Cuna5/CloudFlyIMU/恒温AI_IMU姿态测量系统方案.md

# 基于恒温控制、神经网络零漂预测与自适应 EKF 的智能 IMU 姿态测量系统方案

## 1. 项目名称

**基于恒温控制、神经网络零漂预测与自适应 EKF 的智能 IMU 姿态测量系统**

也可以作为课程设计题目写成：

> **基于多传感器融合与温漂补偿的高稳定 IMU 姿态检测系统**

---

## 2. 项目背景与意义

MEMS IMU 在无人机、机器人、机械臂、室内定位和姿态测量系统中应用广泛。但在实际使用过程中，IMU 会受到温度变化、陀螺仪零漂、磁场干扰等因素影响，导致姿态角估计不稳定，尤其是偏航角 Yaw 容易产生长期漂移。

本设计针对以下问题：

```text
1. 温度变化导致 BMI088 零漂变化；
2. 陀螺仪零漂导致姿态角长期漂移；
3. 磁力计受到干扰时，九轴融合容易把 Yaw 拉偏；
4. 普通六轴/九轴算法无法根据磁场可靠性自适应切换。
```

因此，本系统提出一种结合：

```text
恒温控制
+
神经网络零漂预测
+
磁干扰检测
+
自适应 EKF 姿态融合
```

的智能 IMU 姿态测量方案，以提升复杂环境下姿态估计的稳定性和鲁棒性。

---

## 3. 总体设计目标

本系统的目标不是单纯读取 IMU 数据，而是构建一个具有误差抑制能力的智能姿态测量模块。

### 3.1 核心目标

```text
1. 通过电阻加热和 PID 控制，使 IMU 工作在稳定温度区间；
2. 采集 BMI088 在不同温度下的静止零漂数据；
3. 利用神经网络预测陀螺仪零偏 bgx、bgy、bgz；
4. 利用 EKF 融合陀螺仪、加速度计和磁力计数据；
5. 检测磁干扰，并根据磁场可靠性动态调整磁力计权重；
6. 在磁干扰环境下自动退化为六轴融合，在磁场正常时使用九轴融合；
7. 通过上位机显示温度、零漂、磁场可靠性和姿态角变化。
```

### 3.2 最终实现功能

```text
1. BMI088 六轴数据采集；
2. IST8310 磁力计数据采集；
3. BMP280 温度数据采集；
4. 电阻加热 PID 恒温控制；
5. 陀螺仪零漂数据采集与建模；
6. MLP 神经网络零漂预测；
7. EKF 姿态融合；
8. 磁干扰可靠性判断；
9. 六轴/九轴自适应融合；
10. 姿态角、温度、磁场状态、EKF 模式实时显示。
```

---

## 4. 总体硬件方案

### 4.1 器件选型

| 模块 | 器件 | 作用 |
|---|---|---|
| 主控 | STM32H743IIT6 | 传感器采集、PID 控制、AI 推理、EKF 融合、通信 |
| 六轴 IMU | BMI088 | 三轴加速度、三轴陀螺仪 |
| 磁力计 | IST8310 | 地磁测量、九轴融合、磁干扰检测 |
| 温度/气压 | BMP280 | 第一版用于温度反馈或环境参考 |
| 加热器 | 5V 10Ω 5W 功率电阻 | 给 IMU 模块恒温 |
| 开关器件 | YJL3400A N-MOSFET | PWM 控制加热电阻 |
| 参数存储 | W25Q64 (QSPI, 8 MB) | 持久化存储 PID 参数、EKF 初始值等配置，带 CRC32 校验 |
| 显示模块 | OLED，可选 | 显示温度、姿态、磁场状态和 EKF 模式 |
| 通信接口 | USB CDC / UART | 上传数据到 Python / MATLAB 上位机 |
| 上位机 | Python / MATLAB | 数据记录、模型训练、曲线绘制 |

### 4.2 暂定硬件组合

```text
STM32H743IIT6
+
BMI088
+
IST8310
+
BMP280
+
5V 10Ω 5W 功率电阻
+
YJL3400A MOSFET
+
OLED
+
USB CDC / UART
```

---

## 5. 系统结构设计

### 5.1 系统功能框图

```text
BMI088
  ├── 加速度 ax, ay, az
  └── 角速度 gx, gy, gz

IST8310
  └── 磁场 mx, my, mz

BMP280
  ├── 温度 T
  └── 气压 P，可选

电阻加热 + MOSFET
  └── 恒温控制

STM32H743
  ├── 传感器数据采集
  ├── PID 恒温控制
  ├── AI 零漂预测
  ├── 磁干扰可靠性判断
  ├── 自适应 EKF 姿态融合
  └── 数据显示与上传
```

### 5.2 系统数据流

```text
BMI088 / IST8310 / BMP280 数据采集
        ↓
温度读取与 PID 恒温控制
        ↓
IMU 原始数据预处理
        ↓
神经网络预测陀螺仪零偏
        ↓
陀螺仪数据补偿
        ↓
磁场可靠性判断
        ↓
自适应 EKF 姿态融合
        ↓
输出 Roll / Pitch / Yaw
        ↓
OLED 显示 / 上位机记录
```

---

## 6. 结构与安装方案

### 6.1 恒温 IMU 模块结构

建议制作一个小型恒温仓，将 BMI088、BMP280、均热层和加热电阻集成在一起。

```text
┌────────────────────────────┐
│          保温外壳            │
│                            │
│   IST8310 磁力计             │ ← 尽量远离加热电流线
│                            │
│   BMI088 + BMP280           │ ← 尽量靠近，处于同一热区
│        ↓                   │
│   铜片 / 铝片均热层           │
│        ↓                   │
│   功率电阻加热              │
│                            │
└────────────────────────────┘
```

### 6.2 安装注意事项

```text
1. BMI088 和 BMP280 尽量靠近；
2. 功率电阻不要直接贴 BMI088 芯片；
3. 电阻和 IMU 之间加入铜片或铝片作为均热层；
4. IST8310 尽量远离功率电阻、MOSFET 和加热电源线；
5. 加热线正负线应并排走线，减少磁场环路；
6. MOSFET 建议放在恒温仓外部；
7. 恒温仓可使用泡棉、亚克力或 3D 打印外壳进行保温；
8. 靠近磁力计的位置避免使用铁螺丝，优先使用塑料螺丝、铜螺丝或尼龙柱。
```

---

## 7. 电阻加热与 MOSFET 控制方案

### 7.1 加热器件选择

第一版推荐：

```text
5V 电源
10Ω 5W 功率电阻
最大加热功率约 2.5W
```

计算：

```text
P = V² / R = 5² / 10 = 2.5W
I = V / R = 5 / 10 = 0.5A
```

该功率适合小型 IMU 恒温仓。

### 7.2 MOSFET 选择

使用 **YJL3400A N-MOSFET** 作为低边开关。

### 7.3 接线方式

```text
5V 正极
  ↓
10Ω 加热电阻
  ↓
YJL3400A D 极
YJL3400A S 极
  ↓
GND
```

控制端：

```text
STM32 PWM 引脚 → 100Ω 电阻 → MOSFET G 极
MOSFET G 极 → 10k 下拉电阻 → GND
```

注意：

```text
1. STM32 GND、加热电源 GND 必须共地；
2. MOSFET 要确认 G、D、S 引脚顺序；
3. 加热电流线应远离 IST8310；
4. 加热电源线正负线尽量靠近布线；
5. 软件必须设置过温保护。
```

### 7.4 恒温控制目标

推荐恒温目标：

```text
目标温度：40℃ 或 45℃
允许波动：±0.5℃ 左右
安全断电温度：55℃
```

PWM 频率建议：

```text
1 Hz ~ 10 Hz
```

加热是慢系统，不需要高频 PWM。

---

## 8. 软件总体架构

软件可以分为 6 层：

```text
1. 传感器采集层
   - BMI088
   - IST8310
   - BMP280

2. 恒温控制层
   - PID 控制电阻加热

3. 数据预处理层
   - 单位转换
   - 滤波
   - 归一化
   - 静止检测

4. AI 零漂预测层
   - MLP 预测 bgx、bgy、bgz

5. 自适应 EKF 层
   - 陀螺仪预测
   - 加速度计修正
   - 磁力计修正
   - 磁干扰权重调节

6. 显示与通信层
   - OLED 显示
   - USB CDC / UART 上传
```

### 8.1 主循环流程

```text
1. 读取 BMI088 的 ax、ay、az、gx、gy、gz；
2. 读取 IST8310 的 mx、my、mz；
3. 读取 BMP280 的温度 T；
4. 执行 PID 恒温控制；
5. 对 IMU 数据进行滤波和归一化；
6. 判断当前是否处于静止或低动态状态；
7. AI 模型预测陀螺仪零偏 bgx、bgy、bgz；
8. 对陀螺仪数据进行零偏补偿；
9. EKF 使用陀螺仪进行姿态预测；
10. 加速度计修正 Roll / Pitch；
11. 计算磁场可靠性；
12. 根据磁场可靠性动态调整磁力计观测权重；
13. EKF 输出 Roll / Pitch / Yaw；
14. OLED 显示状态；
15. 上传数据到上位机。
```

---

## 9. EKF 姿态融合设计

### 9.1 状态量设计

推荐 EKF 状态量：

```text
x = [q0, q1, q2, q3, bgx, bgy, bgz]
```

其中：

| 状态量 | 含义 |
|---|---|
| q0, q1, q2, q3 | 姿态四元数 |
| bgx, bgy, bgz | 陀螺仪零偏 |

### 9.2 预测步骤

陀螺仪原始测量值：

```text
ω_raw = [gx, gy, gz]
```

AI 或 EKF 估计的零偏：

```text
b_g = [bgx, bgy, bgz]
```

补偿后的角速度：

```text
ω = ω_raw - b_g
```

利用角速度进行四元数预测：

```text
q_k = q_{k-1} + 1/2 · Ω(ω) · q_{k-1} · dt
```

然后归一化：

```text
q_k = q_k / ||q_k||
```

### 9.3 加速度计更新

加速度计在静止或低动态情况下主要测量重力方向。

理论重力方向：

```text
g_n = [0, 0, 1]
```

根据当前四元数预测机体系下重力方向：

```text
g_b_pred = R(q)^T · g_n
```

实际加速度归一化：

```text
a_meas = [ax, ay, az] / ||a||
```

残差：

```text
r_acc = a_meas - g_b_pred
```

EKF 使用该残差修正 Roll 和 Pitch。

### 9.4 磁力计更新

磁力计用于修正 Yaw。

预测机体系下磁场方向：

```text
m_b_pred = R(q)^T · m_n
```

实际磁力计归一化：

```text
m_meas = [mx, my, mz] / ||m||
```

残差：

```text
r_mag = m_meas - m_b_pred
```

EKF 使用该残差修正偏航角 Yaw。

---

## 10. 磁干扰检测与自适应融合

### 10.1 磁干扰问题

九轴融合依赖磁力计修正 Yaw，但磁力计容易受到以下因素干扰：

```text
1. 磁铁；
2. 电机；
3. 大电流导线；
4. 铁磁材料；
5. 加热电流回路；
6. 电源模块和开关电路。
```

因此系统需要判断磁力计是否可信。

### 10.2 磁场模长计算

```text
B = sqrt(mx² + my² + mz²)
```

### 10.3 磁场可靠性评分

定义磁场可靠性：

```text
S_mag ∈ [0, 1]
```

其中：

```text
S_mag = 1：磁场可靠；
S_mag = 0：严重磁干扰。
```

可靠性判断依据：

```text
1. 磁场模长是否明显偏离正常值；
2. 磁场模长变化率是否过大；
3. 磁场方向是否突变；
4. 磁力计 yaw 与陀螺仪短时预测 yaw 是否冲突；
5. 滑动窗口内 mx、my、mz 或 B 的方差是否过大。
```

### 10.4 自适应 EKF 策略

不建议直接硬切换六轴/九轴，而是动态调整磁力计观测噪声。

```text
磁场可靠：
R_mag 较小
EKF 信任磁力计
系统接近九轴融合

磁场干扰：
R_mag 较大
EKF 降低磁力计权重
系统退化为六轴融合
```

可以设计为：

```text
磁场正常：R_mag = R_mag_base
轻微干扰：R_mag = 10 × R_mag_base
严重干扰：R_mag = 1000 × R_mag_base
```

或者使用连续权重：

```text
R_mag = R_mag_base / (S_mag + 0.01)
```

这样可以实现平滑的六轴/九轴自适应融合。

---

## 11. AI 零漂预测方案

### 11.1 AI 预测目标

第一版只预测陀螺仪零偏：

```text
bgx, bgy, bgz
```

不建议第一版直接预测姿态角误差，因为当前方案暂时不加入角度参考传感器，姿态误差标签不容易获得。

### 11.2 零偏补偿方式

```text
gx_corrected = gx_raw - bgx
gy_corrected = gy_raw - bgy
gz_corrected = gz_raw - bgz
```

补偿后的角速度送入 EKF 进行姿态预测。

---

## 12. AI 训练数据采集方案

### 12.1 数据采集原则

训练 AI 零漂预测模型时，第一版主要采集 **静止温漂数据**。

因为静止状态下理论角速度为：

```text
gx_true = 0
gy_true = 0
gz_true = 0
```

所以实际测得的低频角速度偏移可以近似看作陀螺仪零偏。

### 12.2 数据采集阶段

建议分为以下阶段：

```text
阶段 1：室温静止，关闭加热；
阶段 2：开启加热，从室温升到 40℃ 或 45℃；
阶段 3：恒温保持 10~20 分钟；
阶段 4：关闭加热，自然降温；
阶段 5：重复多次，增加数据多样性。
```

### 12.3 数据记录字段

建议 CSV 格式：

```text
time,T,dT,pwm,ax,ay,az,gx,gy,gz,mx,my,mz
```

字段说明：

| 字段 | 含义 |
|---|---|
| time | 时间戳 |
| T | BMP280 温度 |
| dT | 温度变化率 |
| pwm | 加热 PWM 占空比 |
| ax, ay, az | 加速度计数据 |
| gx, gy, gz | 陀螺仪数据 |
| mx, my, mz | 磁力计数据 |

### 12.4 数据采样频率建议

| 数据 | 建议采样频率 |
|---|---|
| BMI088 加速度/陀螺仪 | 200 Hz 或 500 Hz |
| IST8310 磁力计 | 50 Hz 或 100 Hz |
| BMP280 温度 | 5 Hz 或 10 Hz |
| PID 控制周期 | 1 Hz ~ 10 Hz |
| 上位机记录 | 可统一降采样到 50 Hz 或 100 Hz |

---

## 13. AI 标签生成方案

### 13.1 标签来源

静止状态下：

```text
真实角速度 = 0
```

因此：

```text
陀螺仪低频输出 ≈ 陀螺仪零偏
```

### 13.2 标签生成方式

不要直接用瞬时 gx、gy、gz 作为标签，因为其中包含高频噪声。

建议使用滑动平均或低通滤波：

```text
bgx_label = lowpass(gx)
bgy_label = lowpass(gy)
bgz_label = lowpass(gz)
```

推荐窗口：

```text
2 秒 ~ 5 秒滑动窗口
```

### 13.3 静止数据筛选

为了避免运动数据污染零偏标签，需要进行静止检测。

静止条件可以设置为：

```text
|sqrt(ax² + ay² + az²) - 1g| < threshold_acc
且
|gx|, |gy|, |gz| < threshold_gyro
```

只有满足静止条件的数据才用于训练零漂预测模型。

---

## 14. AI 输入特征设计

推荐第一版输入特征：

```text
T
dT/dt
pwm
ax_mean, ay_mean, az_mean
gx_mean, gy_mean, gz_mean
gx_std, gy_std, gz_std
```

输出：

```text
bgx, bgy, bgz
```

可以写成：

```text
输入：10~12 维特征
输出：3 维陀螺仪零偏
```

### 14.1 特征说明

| 特征 | 作用 |
|---|---|
| T | 表征温度对零偏的影响 |
| dT/dt | 表征升温/降温动态过程 |
| pwm | 表征加热状态 |
| ax_mean, ay_mean, az_mean | 辅助判断姿态和静止状态 |
| gx_mean, gy_mean, gz_mean | 当前窗口陀螺仪均值 |
| gx_std, gy_std, gz_std | 当前窗口陀螺仪噪声水平 |

---

## 15. AI 模型结构

推荐使用小型 MLP。

### 15.1 模型结构

```text
输入层：10~12 维
↓
Dense 32 + ReLU
↓
Dense 32 + ReLU
↓
输出层 3
```

输出：

```text
bgx, bgy, bgz
```

如果希望模型更轻量，可以使用：

```text
Dense 16 + ReLU
↓
Dense 16 + ReLU
↓
Output 3
```

### 15.2 损失函数

使用均方误差：

```text
MSELoss
```

### 15.3 评价指标

```text
1. bgx RMSE
2. bgy RMSE
3. bgz RMSE
4. 补偿前后 gx/gy/gz 均值
5. 补偿前后 gx/gy/gz 标准差
6. 补偿前后静止 Yaw 漂移速度
```

---

## 16. AI 训练流程

### 16.1 训练流程

```text
1. 采集 CSV 数据；
2. Python 读取数据；
3. 对数据进行单位转换和滤波；
4. 进行静止检测；
5. 使用滑动窗口提取特征；
6. 使用低通滤波生成零偏标签；
7. 划分训练集、验证集、测试集；
8. 训练 MLP 模型；
9. 评估模型预测误差；
10. 导出权重；
11. 移植到 STM32。
```

### 16.2 数据集划分

建议不要完全随机打乱每个窗口，而是按实验轮次划分：

```text
第 1~3 次升温/降温数据：训练集；
第 4 次升温/降温数据：验证集；
第 5 次升温/降温数据：测试集。
```

这样更能证明模型具有泛化能力。

---

## 17. AI 模型部署方案

### 17.1 推荐方式：手写 MLP 推理

将训练好的权重导出为 C 数组：

```text
W1, b1
W2, b2
W3, b3
```

在 STM32 中手写：

```text
矩阵乘法
ReLU
输出层计算
```

优点：

```text
1. 模型小，运行快；
2. 不依赖复杂 AI 框架；
3. 便于调试；
4. 适合课程设计。
```

### 17.2 可选方式：TensorFlow Lite Micro

优点是更正规，缺点是移植工作量更大。

第一版建议使用 **手写 MLP 推理**。

---

## 18. AI 与 EKF 的结合方式

### 18.1 第一版推荐方式

先采用简单方式：

```text
BMI088 原始角速度
        ↓
AI 预测 bias
        ↓
角速度补偿
        ↓
EKF 姿态融合
```

公式：

```text
gyro_corrected = gyro_raw - bias_ai
```

### 18.2 后续高级方式

后续可以将 AI 输出的 bias 作为 EKF 的伪观测：

```text
z_bias = bias_ai
```

观测模型：

```text
z_bias = b_g + noise
```

这样 EKF 可以综合自身估计和 AI 预测结果。

---

## 19. 实验验证方案

### 19.1 实验一：恒温控制效果实验

目的：

```text
验证电阻加热和 PID 控制能否将 IMU 附近温度稳定在目标温度。
```

实验步骤：

```text
1. 关闭加热，记录自然温度变化；
2. 开启加热，设定目标温度 40℃ 或 45℃；
3. 记录温度曲线和 PWM 占空比；
4. 观察达到目标温度所需时间；
5. 记录稳定后的温度波动范围。
```

评价指标：

```text
1. 稳定时间；
2. 超调量；
3. 稳态误差；
4. 温度波动范围。
```

目标：

```text
温度稳定在目标温度附近，波动约 ±0.5℃。
```

---

### 19.2 实验二：恒温前后零漂对比

目的：

```text
验证恒温控制是否能减小 BMI088 陀螺仪零漂波动。
```

实验步骤：

```text
1. BMI088 静止放置；
2. 关闭恒温，采集 10~20 分钟；
3. 开启恒温，采集 10~20 分钟；
4. 比较 gx、gy、gz 的均值、标准差和漂移趋势。
```

评价指标：

```text
1. 零偏均值；
2. 零偏标准差；
3. 零偏随温度变化曲线；
4. 静止姿态角漂移速度。
```

目标：

```text
恒温后零偏波动减小。
```

---

### 19.3 实验三：AI 零漂补偿效果

目的：

```text
验证 MLP 模型是否能够预测并补偿陀螺仪零漂。
```

实验步骤：

```text
1. 采集静止温漂数据；
2. 训练 MLP 零漂预测模型；
3. 将模型部署到 STM32 或在上位机离线验证；
4. 比较原始 gyro、恒温 gyro、AI 补偿 gyro。
```

评价指标：

```text
1. 补偿前后 gx/gy/gz 均值；
2. 补偿前后 gx/gy/gz 标准差；
3. 补偿前后静止 Yaw 漂移速度；
4. AI 预测 bias 与标签 bias 的 RMSE。
```

目标：

```text
AI 补偿后静止角速度更接近 0，姿态漂移速度降低。
```

---

### 19.4 实验四：磁干扰自适应 EKF 实验

目的：

```text
验证系统能否在磁干扰下自动降低磁力计权重，避免 Yaw 被错误修正。
```

实验步骤：

```text
1. 正常环境下运行九轴 EKF；
2. 将磁铁、电机或大电流导线靠近 IST8310；
3. 观察磁场模长和磁场可靠性变化；
4. 检查系统是否降低磁力计权重；
5. 移除磁干扰；
6. 观察系统是否恢复九轴融合。
```

显示结果示例：

```text
Mag Reliability: 0.95 → 0.15 → 0.92
EKF Mode: 9-axis → 6-axis → 9-axis
```

目标：

```text
磁干扰时系统不让错误磁力计数据强行修正 Yaw。
```

---

### 19.5 实验五：综合对比实验

比较以下三种方案：

```text
1. 普通六轴姿态解算；
2. 普通九轴姿态解算；
3. 恒温 + AI 零漂预测 + 自适应 EKF。
```

评价指标：

```text
1. 静止漂移量；
2. 磁干扰下 Yaw 跳变量；
3. 温度变化下零偏波动；
4. 姿态角稳定性；
5. 系统模式切换是否平滑。
```

---

## 20. 上位机显示与数据记录

建议上位机使用 Python 或 MATLAB。

### 20.1 需要绘制的曲线

```text
1. 温度 T 曲线；
2. PWM 占空比曲线；
3. gx、gy、gz 原始零偏曲线；
4. AI 预测 bgx、bgy、bgz 曲线；
5. 补偿前后角速度曲线；
6. 磁场模长 B 曲线；
7. 磁场可靠性 S_mag 曲线；
8. Roll / Pitch / Yaw 曲线；
9. EKF 模式变化曲线。
```

### 20.2 OLED 显示内容

可以显示：

```text
Temp: 45.1 C
PWM: 38 %
Mag: Normal / Disturbed
Mode: 9-axis / 6-axis / Adaptive
Bias gx: 0.003 dps
Roll: 1.2 deg
Pitch: -0.5 deg
Yaw: 83.6 deg
```

---

## 21. 开发顺序建议

推荐按以下顺序开发：

```text
第一步：调通 BMI088，输出 ax/ay/az/gx/gy/gz；
第二步：调通 BMP280，读取温度；
第三步：MOSFET 控制电阻加热；
第四步：实现 PID 恒温控制；
第五步：采集无恒温/恒温零漂数据；
第六步：训练 MLP 零漂预测模型；
第七步：STM32 部署 AI 推理；
第八步：调通 IST8310；
第九步：实现六轴 EKF；
第十步：加入磁力计，变成九轴 EKF；
第十一步：加入磁干扰检测和自适应权重；
第十二步：完成实验对比和报告图表。
```

---

## 22. 项目创新点

可以在报告中这样描述：

> 本系统针对 MEMS IMU 在温度变化和磁场干扰环境下姿态测量精度下降的问题，提出一种结合恒温控制、神经网络零漂预测和自适应 EKF 融合的姿态测量方法。系统首先通过功率电阻、MOSFET 和温度传感器构建恒温闭环，使 BMI088 工作在稳定温度区间；随后利用神经网络建立温度、原始惯性数据与陀螺仪零偏之间的非线性映射关系，实现陀螺仪零漂预测与补偿；最后根据磁场模长、方向变化和磁偏航残差构建磁场可靠性指标，动态调整 EKF 中磁力计观测噪声，实现六轴与九轴融合的平滑自适应切换，从而提高姿态测量系统在温漂和磁干扰环境下的稳定性与鲁棒性。

---

## 23. 当前方案优点

```text
1. 传感器课程特色明显：涉及 IMU、磁力计、温度传感器和加热控制；
2. 控制系统完整：包含电阻加热、MOSFET 驱动和 PID 恒温；
3. AI 应用合理：不是为了分类而分类，而是用于零漂预测和误差补偿；
4. 融合算法有深度：加入 EKF 和磁干扰自适应权重；
5. 工程应用明确：可扩展到无人机、机器人、机械臂、室内导航等姿态测量场景；
6. 实验验证可量化：可以通过零偏、温度、Yaw 漂移和磁干扰响应曲线证明效果。
```

---

## 24. 当前方案可能的不足与改进方向

### 24.1 BMP280 温度反馈精度有限

BMP280 的温度读数主要用于气压补偿，第一版可以暂时代替温度反馈，但如果追求更高精度，后续可替换或增加：

```text
TMP117
NTC
PT100 / PT1000
```

### 24.2 暂时没有角度参考

当前方案不加入 AS5600 或转台，因此第一版主要验证：

```text
1. 零偏是否减小；
2. 姿态漂移是否降低；
3. 磁干扰时系统是否能自适应切换。
```

如果后续需要验证绝对角度精度，可以增加：

```text
AS5600 磁编码器
步进电机转台
光电编码器
```

### 24.3 磁力计容易受结构影响

后续需要进行：

```text
硬铁校准
软铁校准
安装位置优化
磁干扰实验
```

### 24.4 AI 模型依赖训练数据质量

训练数据需要覆盖：

```text
升温过程
恒温过程
降温过程
不同环境温度
多次重复实验
```

否则模型泛化能力会较弱。

---

## 25. 最终确定版方案

当前第一版总体方案确定为：

```text
STM32H743IIT6
+
BMI088
+
IST8310
+
BMP280
+
5V 10Ω 5W 电阻加热
+
YJL3400A MOSFET PWM 控制
+
W25Q64 QSPI Flash（参数持久化）
+
PID 恒温
+
MLP 零漂预测
+
自适应 EKF 姿态融合
```

核心技术路线：

```text
恒温控制 → 降低温漂
AI 零漂预测 → 补偿陀螺仪 bias
磁干扰检测 → 判断磁力计可靠性
自适应 EKF → 平滑切换六轴/九轴融合
```

该方案具有较强的课程设计完整性，也具备进一步扩展到无人机、机器人和高稳定姿态测量模块的应用价值。
