Cuna5/CloudFlyIMU/CloudFlyIMU.ioc

Mcu.UserName=STM32H743IITx
PA11.Signal=USB_OTG_FS_DM
PA12.Signal=USB_OTG_FS_DP
PA5.GPIO_Label=BMI_SCK
PA5.Signal=SPI1_SCK
PA6.GPIO_Label=BMI_MISO
PA6.Signal=SPI1_MISO
PA7.GPIO_Label=BMI_MOSI
PA7.Signal=SPI1_MOSI
PA8.Signal=I2C3_SCL
PB10.GPIO_Label=OLED_SCK
PB10.Signal=SPI2_SCK
PB12.GPIO_Label=OLED_RST
PB12.Signal=GPIO_Output
PB14.GPIO_Label=DEBUG_TX
PB14.Signal=USART1_TX
PB15.GPIO_Label=DEBUG_RX
PB15.Signal=USART1_RX
PB6.GPIO_Label=IST_SCL
PB6.Signal=I2C1_SCL
PB7.GPIO_Label=IST_SDA
PB7.Signal=I2C1_SDA
PC0.GPIO_Label=OLED_CS
PC0.Signal=GPIO_Output
PC1.GPIO_Label=OLED_MOSI
PC1.Signal=SPI2_MOSI
PC10.Signal=SDMMC1_D2
PC11.Signal=SDMMC1_D3
PC12.Signal=SDMMC1_CK
PC2_C.GPIO_Label=OLED_MISO
PC2_C.Signal=SPI2_MISO
PC3_C.GPIO_Label=OLED_DC
PC3_C.Signal=GPIO_Output
PC4.GPIO_Label=BMI_ACC_CS
PC4.Signal=GPIO_Output
PC5.GPIO_Label=BMI_GYRO_CS
PC5.Signal=GPIO_Output
PC6.GPIO_Label=HEAT_PWM
PC6.Signal=S_TIM3_CH1
PC8.Signal=SDMMC1_D0
PC9.Signal=SDMMC1_D1
PD2.Signal=SDMMC1_CMD
PH10.GPIO_Label=RGB_R
PH10.Signal=S_TIM5_CH1
PH11.GPIO_Label=RGB_G
PH11.Signal=S_TIM5_CH2
PH12.GPIO_Label=RGB_B
PH12.Signal=S_TIM5_CH3
PH7.GPIO_Label=LED
PH7.Signal=GPIO_Output
PH8.Signal=I2C3_SDA
