Cuna5/CloudFlyIMU/Core/Inc/main.h

#define OLED_CS_Pin GPIO_PIN_0
#define OLED_CS_GPIO_Port GPIOC
#define OLED_MOSI_Pin GPIO_PIN_1
#define OLED_MOSI_GPIO_Port GPIOC
#define OLED_MISO_Pin GPIO_PIN_2
#define OLED_MISO_GPIO_Port GPIOC
#define OLED_DC_Pin GPIO_PIN_3
#define OLED_DC_GPIO_Port GPIOC
#define BMI_SCK_Pin GPIO_PIN_5
#define BMI_SCK_GPIO_Port GPIOA
#define BMI_MISO_Pin GPIO_PIN_6
#define BMI_MISO_GPIO_Port GPIOA
#define BMI_MOSI_Pin GPIO_PIN_7
#define BMI_MOSI_GPIO_Port GPIOA
#define BMI_ACC_CS_Pin GPIO_PIN_4
#define BMI_ACC_CS_GPIO_Port GPIOC
#define BMI_GYRO_CS_Pin GPIO_PIN_5
#define BMI_GYRO_CS_GPIO_Port GPIOC
#define OLED_SCK_Pin GPIO_PIN_10
#define OLED_SCK_GPIO_Port GPIOB
#define LED_Pin GPIO_PIN_7
#define LED_GPIO_Port GPIOH
#define RGB_R_Pin GPIO_PIN_10
#define RGB_R_GPIO_Port GPIOH
#define RGB_G_Pin GPIO_PIN_11
#define RGB_G_GPIO_Port GPIOH
#define RGB_B_Pin GPIO_PIN_12
#define RGB_B_GPIO_Port GPIOH
#define OLED_RST_Pin GPIO_PIN_12
#define OLED_RST_GPIO_Port GPIOB
#define DEBUG_TX_Pin GPIO_PIN_14
#define DEBUG_TX_GPIO_Port GPIOB
#define DEBUG_RX_Pin GPIO_PIN_15
#define DEBUG_RX_GPIO_Port GPIOB
#define HEAT_PWM_Pin GPIO_PIN_6
#define HEAT_PWM_GPIO_Port GPIOC
#define IST_SCL_Pin GPIO_PIN_6
#define IST_SCL_GPIO_Port GPIOB
#define IST_SDA_Pin GPIO_PIN_7
#define IST_SDA_GPIO_Port GPIOB
