Cuna5/CloudFlyIMU/(commit log)

2026-05-14 Cube初始配置
2026-05-14 基础配置更新
2026-05-19 部分进阶功能更新
2026-05-19 优化工程文件
2026-05-24 代码实测验证
2026-05-28 除AI外的功能实测正常
2026-06-12 功能优化
